Jackadminx/KVM-Card/PCB/README.md

您也可以使用立创EDA对原理图和PCB进行在线查看和编辑

https://oshwhub.com/jancgk/kvm-over-usb
