Jackadminx/KVM-Card/PCB/BOM_Board1_PCB1_2022-11-08.xlsx

No. | Quantity | Comment | Designator | Footprint | Value | Manufacturer Part | Manufacturer | Supplier Part | Supplier
1 | 3 | 10uF | C1,C2,C5 | C0603 | 10uF | CL10A106MA8NRNC | SAMSUNG(三星) | C96446 | LCSC
2 | 4 | 100nF | C3,C4,C6,C11 | C0603 | 100nF | CL10B104KO8NNNC | SAMSUNG(三星) | C66501 | LCSC
3 | 4 | 100nF | C7,C8,C12,C13 | C0603 |  | CL10B104KB8NNNC | SAMSUNG | C1591 | LCSC
4 | 2 | 22pF | C9,C10 | C0603 | 22pF | CL10C220JB8NNNC | SAMSUNG(三星) | C1653 | LCSC
5 | 4 | 20pf | C15,C27,C40,C41 | C0603 | 20pf
6 | 3 | 10uf | C17,C18,C28 | C0603 | 10uf
7 | 4 | 22uf | C19,C20,C21,C29 | C0603 | 22uf
8 | 13 | 100nF | C22,C23,C24,C25,C30,C31,C32,C33,C34,C35,C37,C38,C39 | C0603 | 100nF
9 | 1 | 10u | C26 | C0603 | 10u
10 | 1 | 10uF | C36 | CAP-SMD_L3.2-W1.6-RD | 10uF | CA45-A-6.3V-10uF-K | CEC(振华新云) | C128255 | LCSC
11 | 2 | RClamp0524PATCT | D1,D2 | SLP2510P8_L2.5-W1.0-P0.50-BL |  | RClamp0524PATCT | SEMTECH | C40960 | LCSC
12 | 1 | LL4148 | D3 | LL-34_L3.5-W1.5-R-RD |  | LL4148 | ST(先科) |  | LCSC
13 | 2 |  | D5,D6 | SMA_L4.4-W2.8-LS5.4-RD |  |  |  | C727081
14 | 1 |  | H1 | HDR-TH_4P-P2.54-V-M |  |  |  | C492403
15 | 1 | HDMI-019S | HDMI1 | HDMI-SMD_HDMI-019S |  | HDMI-019S | SOFNG(硕方) | C111617 | LCSC
16 | 2 | 2.2uH | L1,L2 | IND-SMD_L2.0-W1.6_1 | 2.2uH | CKCS201610-2.2uH/M | CENKER(岑科) | C354533 | LCSC
17 | 1 |  | LED1 | LED0603-RD_BLUE |  |  |  | C72044
18 | 2 |  | LED4,LED5 | LED0603-RD |  |  |  | C72043
19 | 4 | 5.1K | R1,R2,R3,R4 | R0603 | 5.1K
20 | 2 | 4.7K | R5,R10 | R0603 |  | RMC06034.7k5%N | Tyohm | C269694 | LCSC
21 | 2 | 2K | R6,R9 | R0603 | 2K
22 | 4 | 4k7 | R7,R11,R12,R13 | R0603 | 4k7
23 | 1 | 680K | R14 | R0603 | 680K
24 | 3 | 150K | R15,R16,R20 | R0603 | 150K
25 | 1 | 1k | R17 | R0603 | 1k
26 | 2 | 47k | R18,R19 | R0603 | 47k
27 | 1 | 1K | R21 | R0603 | 1K
28 | 4 | TS-1088-AR02016 | SW1,SW2,SW3,SW4 | SW-SMD_L4.0-W2.9-LS5.0 |  | TS-1088-AR02016 | XUNPU(讯普) | C720477 | LCSC
29 | 2 | CH549G | U1,U3 | SOIC-16_L9.9-W3.9-P1.27-LS6.0-TL
30 | 1 | CH340G | U2 | SOIC-16_L9.9-W3.9-P1.27-LS6.0-BL |  | CH340G | WCH(南京沁恒) | C14267 | LCSC
31 | 1 | SL2.1A | U4 | SOP-16_L10.0-W3.9-P1.27-LS6.0-BL |  | SL2.1A | CoreChips(和芯润德) | C192893 | LCSC
32 | 1 | AT24C16M/TR | U5 | SOP-8_L4.9-W3.9-P1.27-LS6.0-BL |  | AT24C16M/TR | HGSEMI(华冠) | C356701 | LCSC
33 | 2 | MT3520B | U6,U9 | SOT-23-5_L3.0-W1.7-P0.95-LS2.8-BR |  | MT3520B | 西安航天民芯 | C2684933 | LCSC
34 | 2 | BLM18PG121SN1D | U7,U10 | L0603 NSK |  | BLM18PG121SN1D | muRata(村田) | C14709 | LCSC
35 | 1 | MS2109 | U8 | QFN-48_L7.0-W7.0-P0.50-TL-EP4.1
36 | 1 | AMS1117-3.3 | U11 | SOT-223-3_L6.5-W3.4-P2.30-LS7.0-BR |  | AMS1117-3.3 | 美国AMS | C6186 | LCSC
37 | 2 | TYPE-C-31-M-12 | USBC1,USBC2 | USB-C_SMD-TYPE-C-31-M-12 |  | TYPE-C-31-M-12 | Rectangular Connectors - Contacts | C165948 | LCSC
38 | 2 | 12MHz | X1,X2 | CRYSTAL-SMD_4P-L3.2-W2.5-BL | 12MHz | Q22FA23V0041800 | EPSON(爱普生) | C91749 | LCSC
39 | 1 | 24MHz | X3 | OSC-SMD_4P-L3.2-W2.5-BL | - | SX32Y024000BC1T | TKD(泰晶) | C271629 | LCSC
