Jackadminx/KVM-Card/PCB/SCH_Schematic1_2022-11-08.pdf

SL2.1A | Type-C Master | Type-C Slave | CH340G

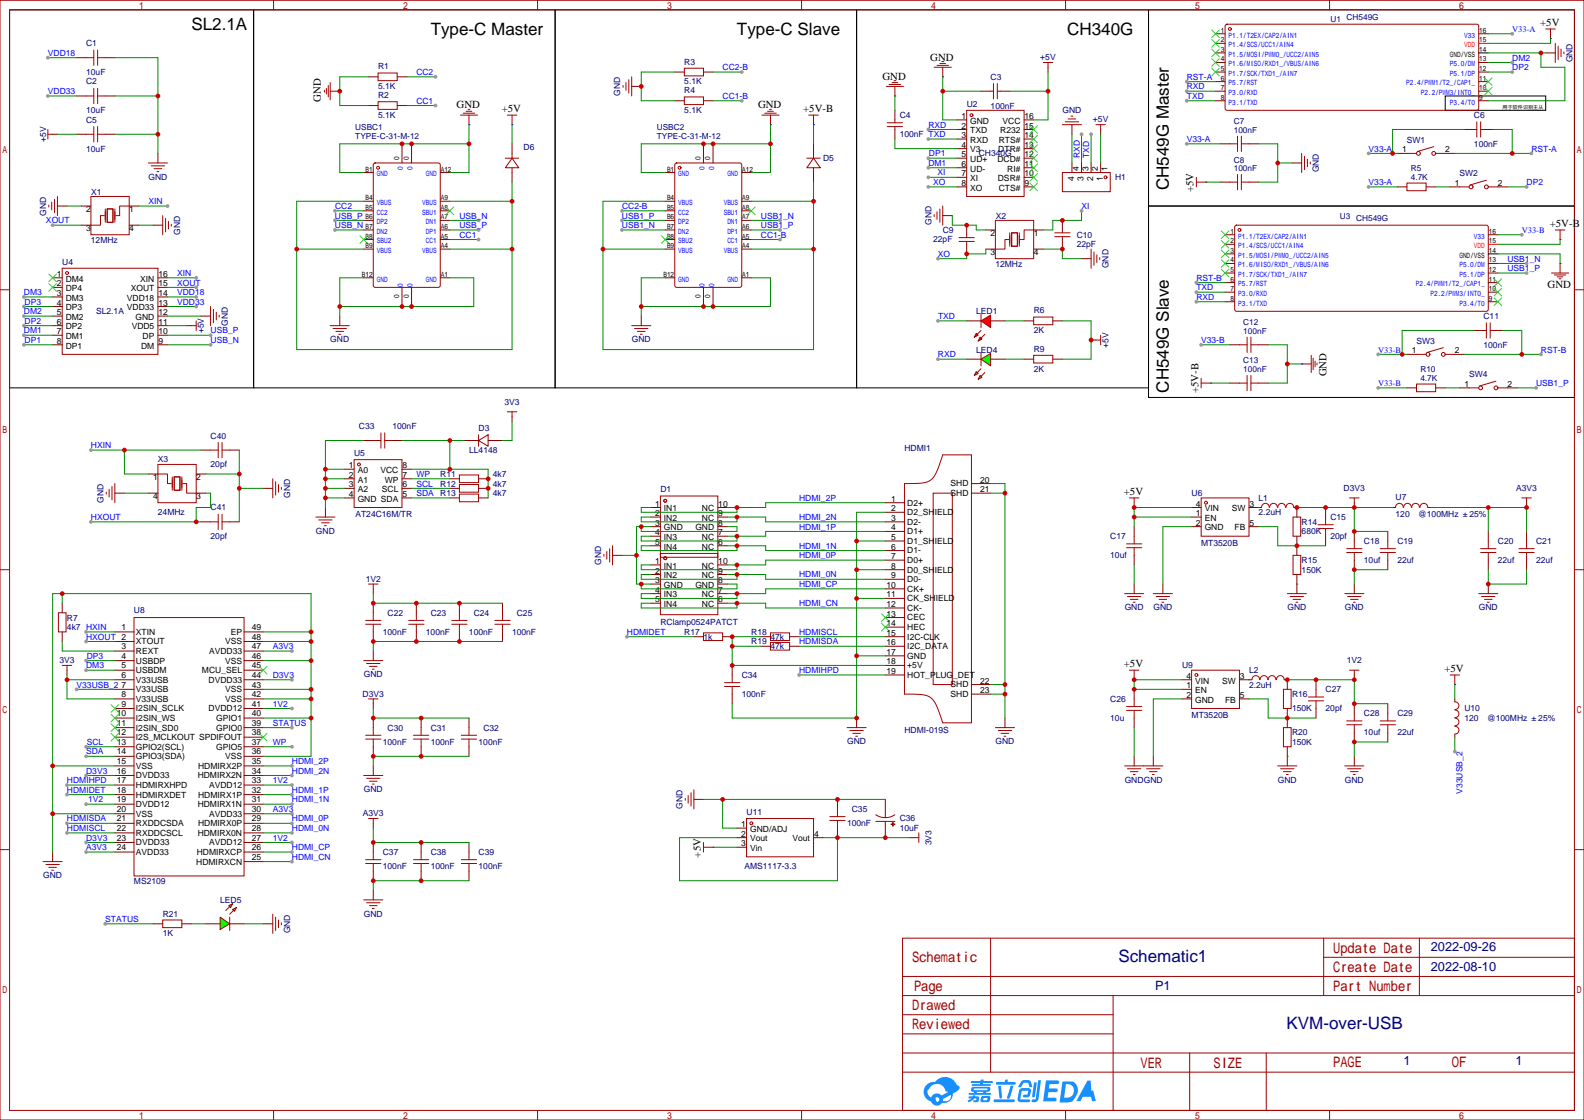
[picture p6: page 1]

DP 10 VDD5 11 GND 12 VDD33 13 VDD18 14 XOUT 15 XIN 16
