Jackadminx/KVM-Card/(threads)

Thread 1 (2023-02-13):

咱们这个有成品吗？

haobinnan, 2023-02-13:
咱们这个有成品吗？

Jackadminx, 2023-02-13:
暂时没有，建议先等等，之后的版本会重新设计硬件结构

haobinnan, 2023-02-13:
方便留个邮箱吗

Jackadminx, 2023-02-13:
[你可以通过Telegram联系到我](https://t.me/Jancgk)

haobinnan, 2023-02-14:
不好意思我没有这个通信工具，尝试申请没弄成功，这个是我的github地址上面有我的邮箱。
https://github.com/haobinnan
