Jackadminx/KVM-Card/(commit log)

2022-11-08 首次提交
2022-11-08 PCB相关内容
    [BOM_Board1_PCB1_2022-11-08.xlsx]
2022-11-08 添加图标
2022-11-08 更新README
